DanNixon/bled/docs/README.md

# BLED Documentation

## Guides

- [Bluetooth Low Energy Pairing](ble-pairing.md) - Bluetooth Low Energy pairing with BLED on Android and Linux.

## Development

- [`bled-effect` SDK](../lib/effect/README.md) - Crate for building WebAssembly effects in Rust.
- [Effects](../effects) - WebAssembly effects written in Rust using `bled-effect`.

## Hardware

- [Pico W Backpack PCB](../pcb/bled-pico-w-backpack/README.md) - Carrier board hardware documentation and BOM.
