DanNixon/bled/pcb/bled-pico-w-backpack/README.md

# Pico W backpack

"Backpack" style addon/carrier board for a Pi Pico W, with SD card slow and four WS2812 outputs.

## Parts

- [Raspberry Pi Pico 2/Pico 2 W](https://www.raspberrypi.com/documentation/microcontrollers/pico-series.html)
- https://jlcpcb.com/partdetail/XINGLIGHT-XL_1615RGBC2812B/C5349954
- https://jlcpcb.com/partdetail/SOFNG-TF15x15/C111196
- https://jlcpcb.com/partdetail/jianfu-TVAU10_025BR/C19271014
- https://jlcpcb.com/partdetail/MDD_Microdiode_Semiconductor-SS34/C8678
- https://jlcpcb.com/partdetail/16204-CL05A106MQ5NUNC/C15525
- https://jlcpcb.com/partdetail/50070-CL03A104KP3NNNC/C49062
- https://jlcpcb.com/partdetail/288614-RC01W473JT/C304547
