DanNixon/bled/pcb/bled-pico-w-backpack/bled-pico-w-backpack.kicad_pcb

## KiCad design pcb/bled-pico-w-backpack/bled-pico-w-backpack.kicad_pcb (2026-09-30)

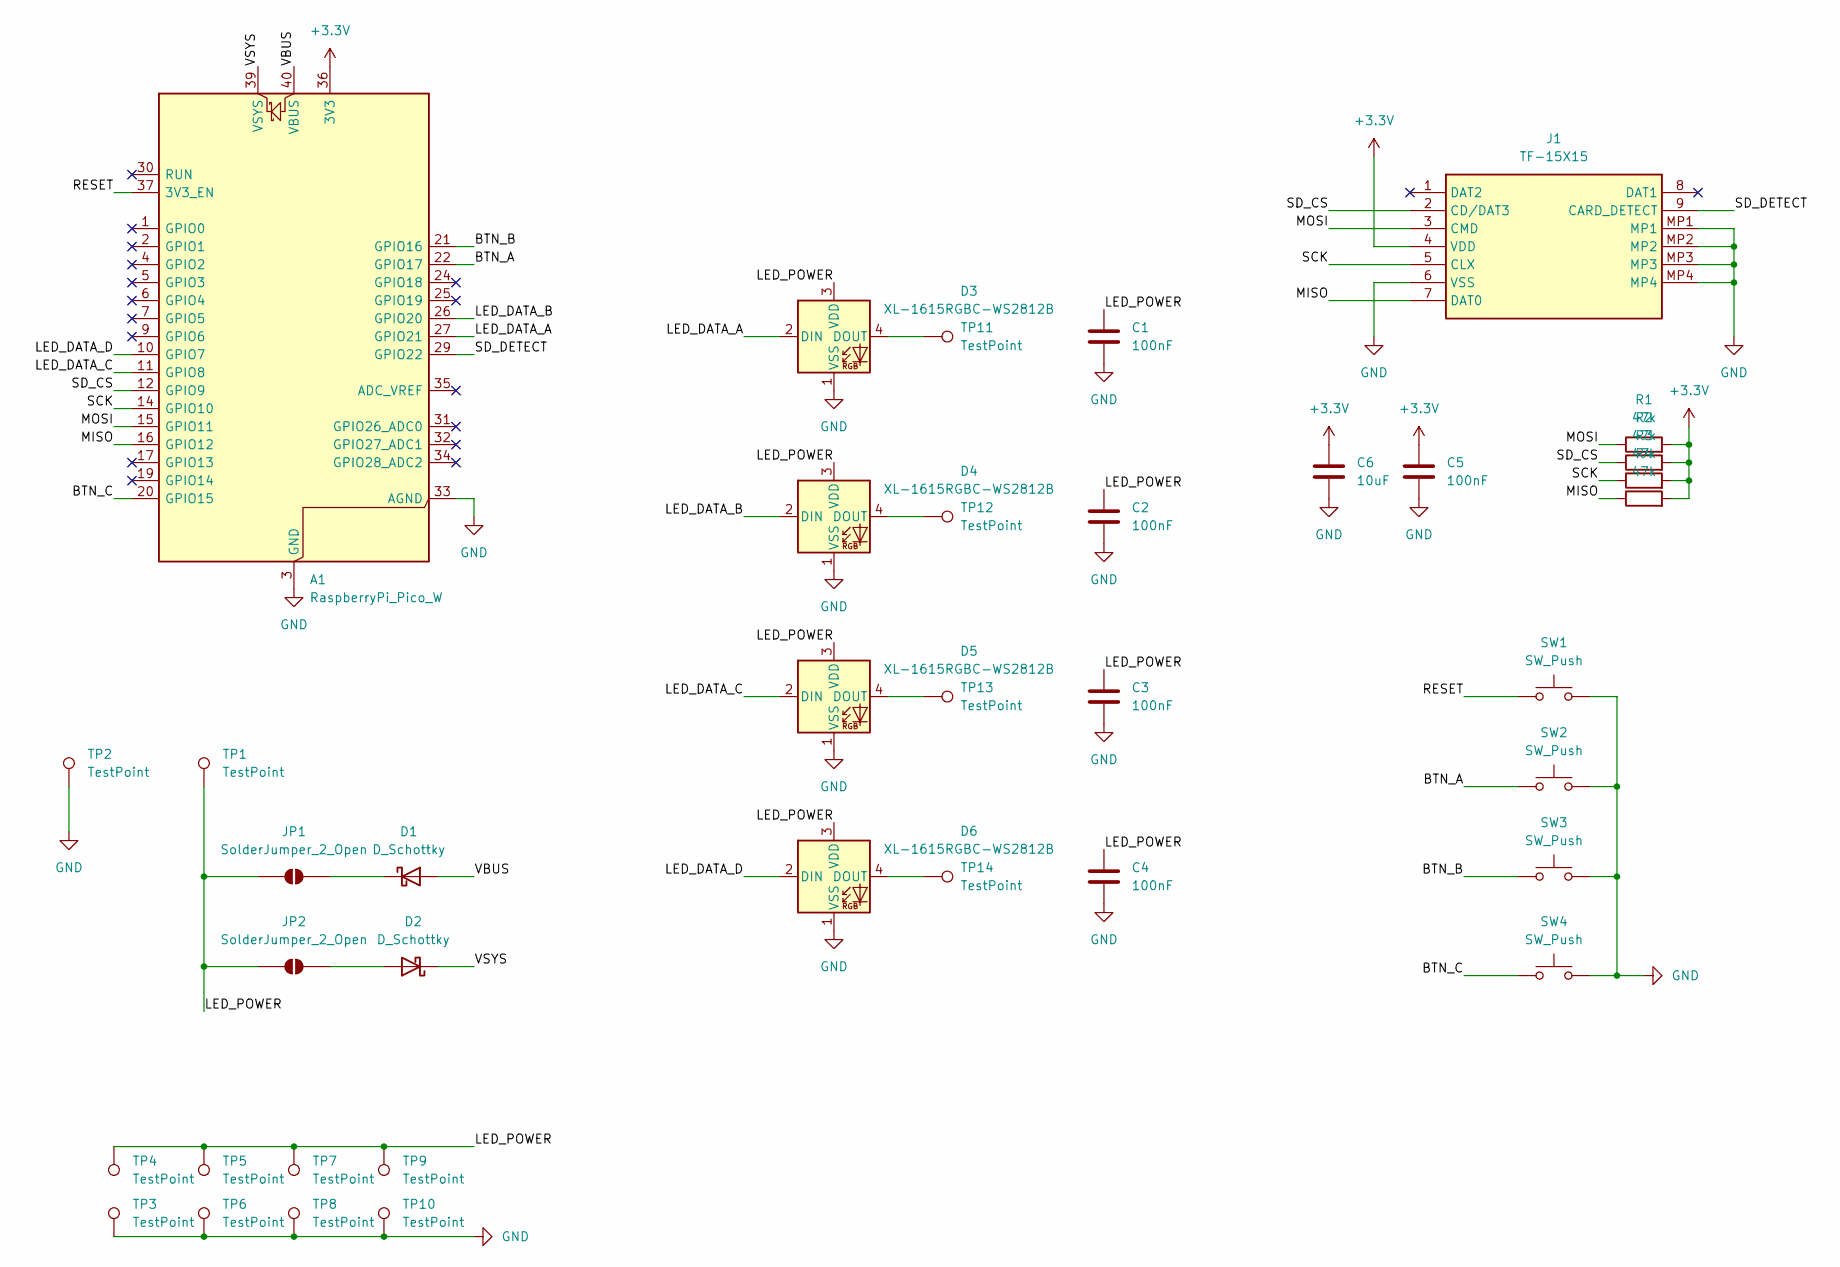
[picture p2: schematic bled-pico-w-backpack.kicad_sch]

Parts:
A1: RaspberryPi_Pico_W; RaspberryPi_Pico_Common_SMD
C1, C2, C3, C4, C5: 100nF; C_0201_0603Metric; LCSC C49062
C6: 10uF; C_0402_1005Metric; LCSC C15525
D1, D2: D_Schottky; D_SMA; LCSC C8678
D3, D4, D5, D6: XL-1615RGBC-WS2812B; XL-1615RGBC-2812B; LCSC C5349954
J1: TF-15X15; TF15X15; Manufacturer_Part_Number TF-15X15; LCSC C111196
JP1, JP2: SolderJumper_2_Open; SolderJumper-2_P1.3mm_Open_RoundedPad1.0x1.5mm
R1, R2, R3, R4: 47k; R_0201_0603Metric; LCSC C304547
SW1, SW2, SW3, SW4: SW_Push; TVAU10-025B-R; LCSC C19271014
TP1, TP2, TP3, TP4, TP5, TP6, TP7, TP8, TP9, TP10: TestPoint; TestPoint_Pad_2.5x2.5mm
TP11, TP12, TP13, TP14: TestPoint; TestPoint_Pad_D2.0mm

Connections:
+3.3V: A1.36 (3V3), C5.1, C6.1, J1.4 (VDD), R1.2, R2.2, R3.2, R4.2
/BTN_A: A1.22 (GPIO17), SW2.1
/BTN_B: A1.21 (GPIO16), SW3.1
/BTN_C: A1.20 (GPIO15), SW4.1
/LED_DATA_A: A1.27 (GPIO21), D3.2 (DIN)
/LED_DATA_B: A1.26 (GPIO20), D4.2 (DIN)
/LED_DATA_C: A1.11 (GPIO8), D5.2 (DIN)
/LED_DATA_D: A1.10 (GPIO7), D6.2 (DIN)
/LED_POWER: C1.1, C2.1, C3.1, C4.1, D3.3 (VDD), D4.3 (VDD), D5.3 (VDD), D6.3 (VDD), JP1.2 (B), JP2.1 (A), TP1.1 (1_1), TP4.1 (1_1), TP5.1 (1_1), TP7.1 (1_1), TP9.1 (1_1)
/MISO: A1.16 (GPIO12), J1.7 (DAT0), R4.1
/MOSI: A1.15 (GPIO11), J1.3 (CMD), R1.1
/RESET: A1.37 (3V3_EN), SW1.1
/SCK: A1.14 (GPIO10), J1.5 (CLX), R3.1
/SD_CS: A1.12 (GPIO9), J1.2 (CD/DAT3), R2.1
/SD_DETECT: A1.29 (GPIO22), J1.9 (CARD_DETECT)
/VBUS: A1.40 (VBUS), D1.2 (A)
/VSYS: A1.39 (VSYS), D2.1 (K)
GND: A1.3 (GND), A1.8 (GND), A1.13 (GND), A1.18 (GND), A1.23 (GND), A1.28 (GND), A1.33 (AGND), A1.38 (GND), C1.2, C2.2, C3.2, C4.2, C5.2, C6.2, D3.1 (VSS), D4.1 (VSS), D5.1 (VSS), D6.1 (VSS), J1.6 (VSS), J1.MP1, J1.MP2, J1.MP3, J1.MP4, SW1.2, SW2.2, SW3.2, SW4.2, TP2.1 (1_1), TP3.1 (1_1), TP6.1 (1_1), TP8.1 (1_1), TP10.1 (1_1)
unnamed: D1.1 (K), JP1.1 (A)
unnamed: D2.2 (A), JP2.2 (B)
unnamed: D3.4 (DOUT), TP11.1 (1_1)
unnamed: D4.4 (DOUT), TP12.1 (1_1)
unnamed: D5.4 (DOUT), TP13.1 (1_1)
unnamed: D6.4 (DOUT), TP14.1 (1_1)

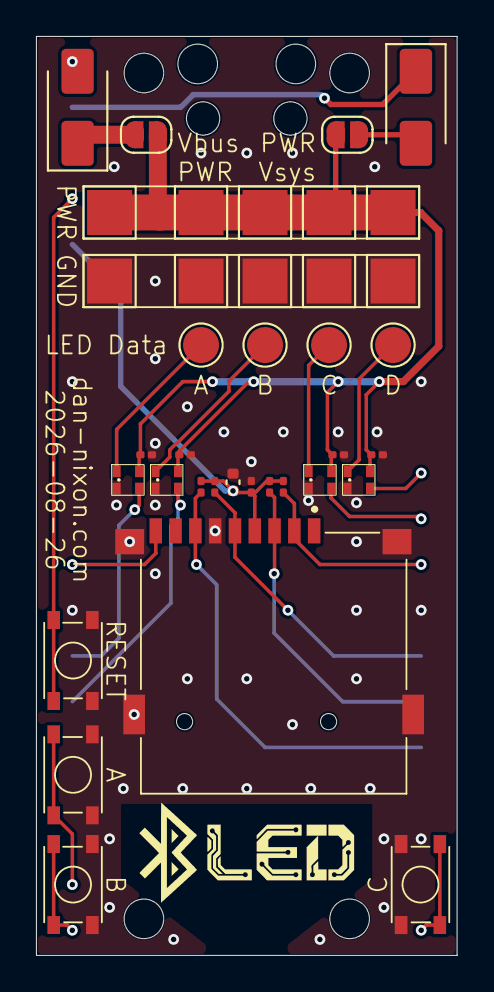
[picture p3: board bled-pico-w-backpack.kicad_pcb from above]

Board: 2 copper layers, 23.4 x 51.1 mm, 38 parts (1 on the bottom side), 24 nets.
