DanNixon/bled/firmware/src/sdcard/mod.rs

pub(crate) mod block_device;

pub(super) use block_device::*;

use bled_core::{
    PathString,
    api::{DirEntry, DirEntryType},
};
use defmt::{Format, warn};
use embassy_sync::{blocking_mutex::raw::CriticalSectionRawMutex, mutex::Mutex};
use exfat_slim::blocking::error::ExFatError;
pub(crate) use exfat_slim::blocking::file::{File, OpenOptions};
use static_cell::StaticCell;

pub(crate) type DirectoryIterator = exfat_slim::blocking::directory::DirectoryIterator<512>;

#[derive(Debug, Format)]
pub(crate) enum ReadFileError {
    Open(FsError),
    FileTooLarge { len: usize, capacity: usize },
    Read(FsError),
}

#[derive(Clone)]
pub(crate) struct SdCardStorage {
    fs: &'static Mutex<CriticalSectionRawMutex, FileSystem>,
}

static SD_FS: StaticCell<Mutex<CriticalSectionRawMutex, FileSystem>> = StaticCell::new();

impl SdCardStorage {
    pub(super) fn new(sdcard: SdBlockDevice) -> SdCardStorage {
        let fs = FileSystem::new(sdcard);
        let fs = SD_FS.init(Mutex::new(fs));
        SdCardStorage { fs }
    }

    async fn with_filesystem<T>(&self, operation: impl FnOnce(&mut FileSystem) -> T) -> T {
        let mut fs = self.fs.lock().await;
        operation(&mut fs)
    }

    #[inline(never)]
    pub(crate) async fn read_file(
        &self,
        filename: &str,
        bytes: &mut [u8],
    ) -> Result<usize, ReadFileError> {
        self.with_filesystem(
            |fs| match fs.open(filename, OpenOptions::new().read(true)) {
                Ok(mut file) => {
                    let len = file.metadata().len() as usize;
                    if len > bytes.len() {
                        warn!(
                            "file {} is too large ({} > {} bytes)",
                            filename,
                            len,
                            bytes.len()
                        );
                        let _ = file.close(fs);
                        return Err(ReadFileError::FileTooLarge {
                            len,
                            capacity: bytes.len(),
                        });
                    }

                    let read_result = match file.read(fs, &mut bytes[..len]) {
                        Ok(Some(n)) => Ok(n),
                        Ok(None) => Ok(0),
                        Err(e) => {
                            warn!("failed to read file {}: {}", filename, e);
                            Err(ReadFileError::Read(e))
                        }
                    };
                    let close_result = file.close(fs).map_err(ReadFileError::Read);
                    match (read_result, close_result) {
                        (Ok(bytes_read), Ok(())) => Ok(bytes_read),
                        (Err(error), _) | (_, Err(error)) => Err(error),
                    }
                }
                Err(e) => {
                    warn!("failed to open file {}: {}", filename, e);
                    Err(ReadFileError::Open(e))
                }
            },
        )
        .await
    }

    #[inline(never)]
    pub(crate) async fn write_file(&self, filename: &str, bytes: &[u8]) -> Result<(), FsError> {
        self.with_filesystem(|fs| {
            fs.write(filename, bytes).map_err(|e| {
                warn!("failed to write file {}: {}", filename, e);
                e
            })
        })
        .await
    }

    #[inline(never)]
    pub(crate) async fn open_file(
        &self,
        filename: &str,
        options: OpenOptions,
    ) -> Result<File, FsError> {
        self.with_filesystem(|fs| {
            fs.open(filename, options).map_err(|e| {
                warn!("failed to open file {}: {}", filename, e);
                e
            })
        })
        .await
    }

    #[inline(never)]
    pub(crate) async fn seek_file(&self, file: &mut File, offset: u64) -> Result<(), FsError> {
        self.with_filesystem(|fs| {
            file.seek(fs, offset).map_err(|e| {
                warn!("failed to seek in file {}: {}", offset, e);
                e
            })
        })
        .await
    }

    #[inline(never)]
    pub(crate) async fn read_open_file(
        &self,
        file: &mut File,
        buf: &mut [u8],
    ) -> Result<usize, FsError> {
        self.with_filesystem(|fs| match file.read(fs, buf) {
            Ok(Some(n)) => Ok(n),
            Ok(None) => Ok(0),
            Err(e) => {
                warn!("failed to read from file: {}", e);
                Err(e)
            }
        })
        .await
    }

    #[inline(never)]
    pub(crate) async fn write_open_file(&self, file: &mut File, buf: &[u8]) -> Result<(), FsError> {
        self.with_filesystem(|fs| {
            file.write(fs, buf).map_err(|e| {
                warn!("failed to write to file: {}", e);
                e
            })
        })
        .await
    }

    #[inline(never)]
    pub(crate) async fn close_file(&self, file: File) -> Result<(), FsError> {
        self.with_filesystem(|fs| {
            file.close(fs).map_err(|e| {
                warn!("failed to close file: {}", e);
                e
            })
        })
        .await
    }

    #[inline(never)]
    pub(crate) async fn stat_file(&self, filename: &str) -> Result<u64, FsError> {
        self.with_filesystem(|fs| {
            match fs.open(filename, OpenOptions::new().read(true).write(true)) {
                Ok(file) => {
                    let len = file.metadata().len();
                    file.close(fs).map_err(|e| {
                        warn!("failed to close file after stat {}: {}", filename, e);
                        e
                    })?;
                    Ok(len)
                }
                Err(e) => {
                    warn!("failed to open file {}: {}", filename, e);
                    Err(e)
                }
            }
        })
        .await
    }

    #[inline(never)]
    pub(crate) async fn create_file(&self, filename: &str, size: u64) -> Result<(), FsError> {
        let mut file = self
            .open_file(
                filename,
                OpenOptions::new()
                    .read(true)
                    .write(true)
                    .truncate(true)
                    .create(true),
            )
            .await?;

        const CHUNK_SIZE: usize = 512;
        let zeros = [0u8; CHUNK_SIZE];
        let mut remaining = size as usize;

        let write_result: Result<(), FsError> = async {
            while remaining != 0 {
                let chunk_len = remaining.min(CHUNK_SIZE);
                self.write_open_file(&mut file, &zeros[..chunk_len]).await?;
                remaining -= chunk_len;
                embassy_futures::yield_now().await;
            }
            Ok(())
        }
        .await;

        let close_result = self.close_file(file).await;
        write_result?;
        close_result
    }

    #[inline(never)]
    pub(crate) async fn delete_file(&self, filename: &str) -> Result<(), FsError> {
        self.with_filesystem(|fs| {
            fs.remove_file(filename).map_err(|e| {
                warn!("failed to delete file {}: {}", filename, e);
                e
            })
        })
        .await
    }

    #[inline(never)]
    pub(crate) async fn rename_file(&self, from_path: &str, to_path: &str) -> Result<(), FsError> {
        self.with_filesystem(|fs| {
            match fs.remove_file(to_path) {
                Ok(()) | Err(ExFatError::FileNotFound) => {}
                Err(e) => {
                    warn!("failed to delete existing target file {}: {}", to_path, e);
                    return Err(e);
                }
            }

            fs.rename(from_path, to_path).map_err(|e| {
                warn!("failed to rename file {} to {}: {}", from_path, to_path, e);
                e
            })
        })
        .await
    }

    #[inline(never)]
    pub(crate) async fn open_dir(&self, path: &str) -> Result<DirectoryIterator, FsError> {
        self.with_filesystem(|fs| {
            fs.read_dir(path).map_err(|e| {
                warn!("failed to open dir {}: {}", path, e);
                e
            })
        })
        .await
    }

    #[inline(never)]
    pub(crate) async fn next_dir_entry(
        &self,
        dir: &mut DirectoryIterator,
    ) -> Result<Option<DirEntry>, FsError> {
        self.with_filesystem(|fs| {
            let mut name_buf = [0u8; exfat_slim::blocking::directory::MAX_NAME_LEN];
            match dir.next_entry(fs, &mut name_buf) {
                Ok(Some(entry)) => {
                    let mut heapless_name = PathString::new();
                    for c in entry.name.chars() {
                        if heapless_name.len() + c.len_utf8() > heapless_name.capacity() {
                            break;
                        }
                        let _ = heapless_name.push(c);
                    }

                    let kind = if entry.metadata.is_dir() {
                        DirEntryType::Directory
                    } else {
                        DirEntryType::File {
                            size: entry.metadata.len(),
                        }
                    };
                    Ok(Some(DirEntry::new(heapless_name, kind)))
                }
                Ok(None) => Ok(None),
                Err(e) => {
                    warn!("failed to read next dir entry: {}", e);
                    Err(e)
                }
            }
        })
        .await
    }
}

type FileSystem = exfat_slim::blocking::file_system::FileSystem<SdBlockDevice, 512, 4>;

pub(crate) type FsError = ExFatError<SdBlockDeviceError>;
