DanNixon/bled/firmware/src/leds.rs

use bled_core::{
    RGB8,
    config::{ChannelBrightnessLimits, Fixtures},
    pixel_buffer::{PixelDataBuffer, PixelDataChannelSize},
};
use defmt::{debug, unwrap};
use embassy_rp::{
    pio::Pio,
    pio_programs::ws2812::{PioWs2812, PioWs2812Program},
};
use embassy_sync::{
    blocking_mutex::raw::CriticalSectionRawMutex,
    channel::Channel,
    mutex::{Mutex, MutexGuard},
    signal::Signal,
};
use smart_leds::SmartLedsWriteAsync;

pub(crate) const LED_MEMORY: usize = 16 * 1024;
pub(crate) const CHANNEL_COUNT: usize = 4;

static CHANNEL_DATA: Mutex<CriticalSectionRawMutex, PixelDataBuffer<LED_MEMORY, CHANNEL_COUNT>> =
    Mutex::new(PixelDataBuffer::new());
static BRIGHTNESS_LIMITS: Mutex<CriticalSectionRawMutex, ChannelBrightnessLimits<CHANNEL_COUNT>> =
    Mutex::new(ChannelBrightnessLimits::new());

static DRAW_MUTEX: Mutex<CriticalSectionRawMutex, ()> = Mutex::new(());
static DRAW_REQUEST: Channel<CriticalSectionRawMutex, (), 1> = Channel::new();
static DRAW_COMPLETE: Signal<CriticalSectionRawMutex, ()> = Signal::new();

pub(crate) async fn data()
-> MutexGuard<'static, CriticalSectionRawMutex, PixelDataBuffer<LED_MEMORY, CHANNEL_COUNT>> {
    CHANNEL_DATA.lock().await
}

/// Reshapes the LED pixel buffer and updates per-channel brightness limits for the given fixtures.
pub(crate) async fn reconfigure(fixtures: &Fixtures) {
    let channel_sizes: [PixelDataChannelSize; CHANNEL_COUNT] =
        unwrap!(fixtures.channel_lengths::<CHANNEL_COUNT>()).map(PixelDataChannelSize::new::<RGB8>);

    let brightness_limits = unwrap!(ChannelBrightnessLimits::<CHANNEL_COUNT>::from_fixtures(
        fixtures
    ));

    let mut data = CHANNEL_DATA.lock().await;
    data.inner_mut().fill(0);
    unwrap!(data.try_reshape(channel_sizes));
    *BRIGHTNESS_LIMITS.lock().await = brightness_limits;
}

/// Renders the selected channels and returns after the physical write completes.
pub(crate) async fn draw() {
    debug!("Draw requested");
    let _guard = DRAW_MUTEX.lock().await;
    DRAW_REQUEST.send(()).await;
    DRAW_COMPLETE.wait().await;
    debug!("Draw complete");
}

#[embassy_executor::task]
pub(super) async fn task(r: super::LedResources) -> ! {
    let mut pio = Pio::new(r.pio, super::Irqs);
    let program = PioWs2812Program::new(&mut pio.common);

    let mut channel_0 = PioWs2812::new(
        &mut pio.common,
        pio.sm0,
        r.channel_0_pin,
        r.channel_0_dma,
        crate::Irqs,
        &program,
    );
    let mut channel_1 = PioWs2812::new(
        &mut pio.common,
        pio.sm1,
        r.channel_1_pin,
        r.channel_1_dma,
        crate::Irqs,
        &program,
    );
    let mut channel_2 = PioWs2812::new(
        &mut pio.common,
        pio.sm2,
        r.channel_2_pin,
        r.channel_2_dma,
        crate::Irqs,
        &program,
    );
    let mut channel_3 = PioWs2812::new(
        &mut pio.common,
        pio.sm3,
        r.channel_3_pin,
        r.channel_3_dma,
        crate::Irqs,
        &program,
    );

    loop {
        DRAW_REQUEST.receive().await;
        debug!("Draw request");

        let data = CHANNEL_DATA.lock().await;
        let brightness_limits = BRIGHTNESS_LIMITS.lock().await;

        for channel in 0..CHANNEL_COUNT {
            if let Ok(pixels) = data.try_channel::<RGB8>(channel) {
                let pixels = unwrap!(brightness_limits.apply_channel(channel, pixels));
                match channel {
                    0 => channel_0.write(pixels).await.unwrap(),
                    1 => channel_1.write(pixels).await.unwrap(),
                    2 => channel_2.write(pixels).await.unwrap(),
                    3 => channel_3.write(pixels).await.unwrap(),
                    _ => unreachable!(),
                }
            }
        }

        DRAW_COMPLETE.signal(());
    }
}
