DanNixon/bled/(commit log)

2026-10-02 Bump btleplug in /cli in the cargo-dependencies group across 1 directory
    Bumps the cargo-dependencies group with 1 update in the /cli directory: [btleplug](https://github.com/deviceplug/btleplug).
    Updates `btleplug` from 0.13.2 to 0.13.3
    - [Changelog](https://github.com/deviceplug/btleplug/blob/master/CHANGELOG.md)
    - [Commits](https://github.com/deviceplug/btleplug/compare/0.13.2...0.13.3)
    ---
    updated-dependencies:
    - dependency-name: btleplug
    dependency-version: 0.13.3
    dependency-type: direct:production
    update-type: version-update:semver-patch
    dependency-group: cargo-dependencies
    ...
2026-10-03 Split WebAssembly protocol bindings into modules
    [config.rs]
2026-10-04 Increase SD card SPI frequency
2026-10-04 Add LED buffer read/write per channel/segment to web UI
2026-10-11 Redesign device configuration around fixtures and spans
    Add configuration validation and channel sizing, reorganize core API
    types, and update firmware and web tooling for the new model. Remove
    channel-mask commits and legacy channel-buffer controls.
2026-10-16 Add USB MSC support
    Allows the SD card to be mounted via USB when button B is held on boot.
2026-10-19 Add Pico 2 support
2026-10-19 Name firmware artifacts by board variant
2026-10-19 Don't require building to attach
2026-11-01 Improve board specific hardware handling
2026-11-14 Replace monolithic DeviceConfig with DeviceName and Fixtures RPCs
    Add a DeviceName nutype with a default of "bled-default" and include it
    in DeviceInfo. Remove DeviceConfig in favour of standalone Fixtures
    constants and replace the ConfigStat/ConfigRead RPC requests with
    FixturesStat, FixturesRead, and FixturesReload.
2026-11-14 Split device configuration across separate SD card files in firmware
    Replace /config.json with /device-name.txt, /ble-passkey.txt,
    /fixtures.json, and /default-effect.txt. Load device name and default
    effect once at boot, read the BLE passkey from the SD card on each BLE
    connection, and support on-demand fixture reloads via FixturesReload
    (reshaping the LED buffer, updating brightness limits, and reloading any
    active effect). When a config file cannot be read or validated, rename
    it with an "_old" suffix and write out the default file.
2026-11-14 Update web client and UI for split configuration and fixture RPCs
    Use DeviceInfo.name for the device display name, replace config_stat and
    config_read with fixtures_stat, fixtures_read, and fixtures_reload, and
    wire up the Reload Fixtures action in the device info view.
